CarletonURocketry/CU-in-Space-2018-Avionics-Hardware/main.brd

## EAGLE design main.brd (2018-06-05)

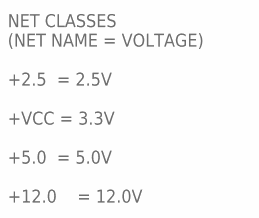
[picture p1: schematic main.sch, sheet 1]

Notes on the sheet:
NET CLASSES (NET NAME = VOLTAGE) +2.5 = 2.5V +VCC = 3.3V +5.0 = 5.0V +12.0 = 12.0V

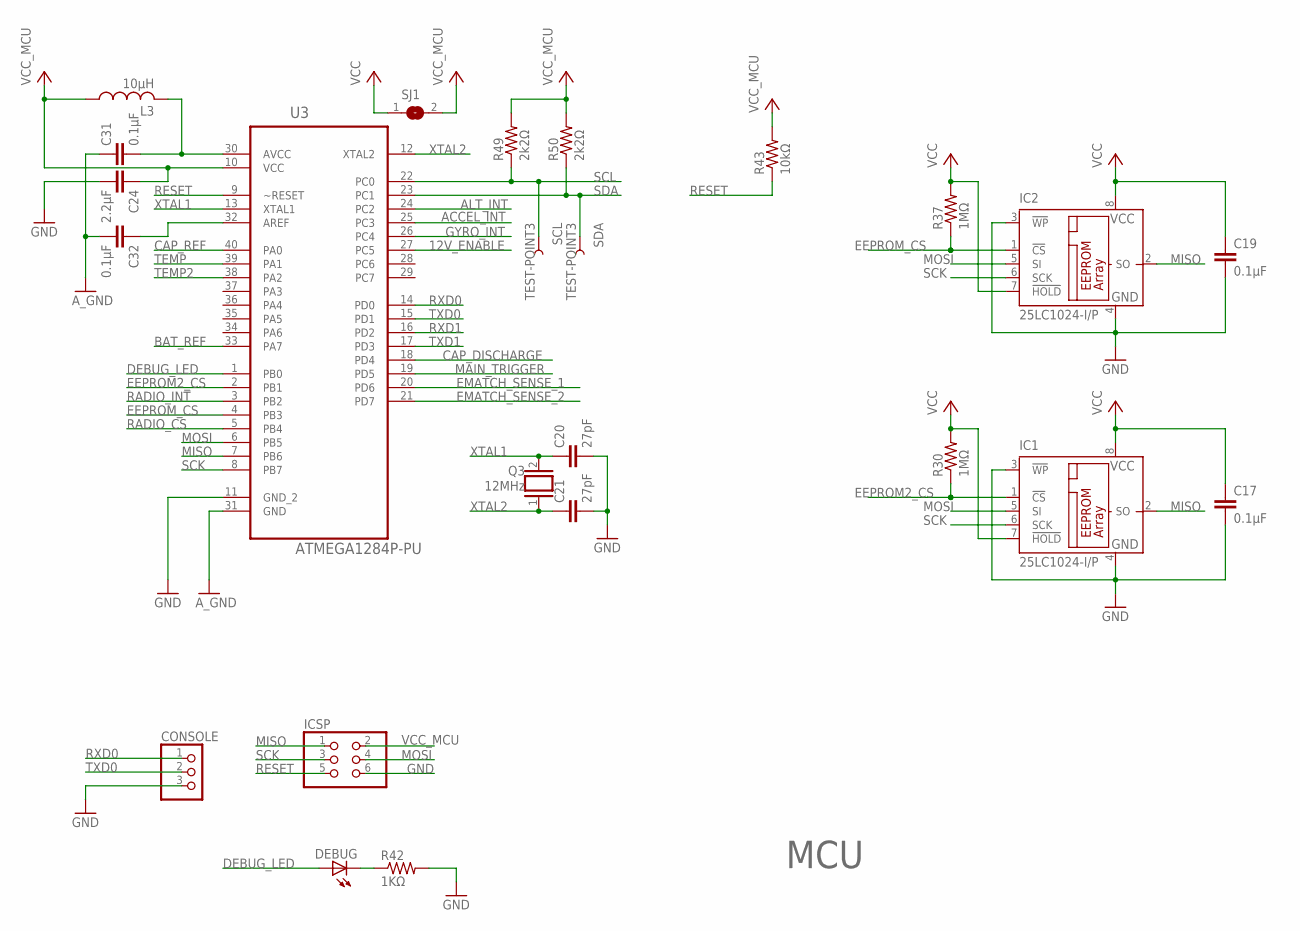
[picture p2: schematic main.sch, sheet 2, MCU]

Parts:
C17, C19, C31, C32: 0.1µF; C025-025X050
C20, C21: 27pF; C025-025X050
C24: 2.2µF; C025-025X050
CONSOLE: PINHD-1X3; 1X03
DEBUG: LED5MM
IC1, IC2: 25LC1024-I/P; DIL8
ICSP: PINHD-2X3; 2X03
L3: 10µH; 0207/5V
Q3: 12MHz; QS
R30, R37: 1MΩ; 0207/5V
R42: 1KΩ; 0207/5V
R43: 10kΩ; 0207/5V
R49, R50: 2k2Ω; 0207/5V
SCL: TEST-POINT3; PAD.03X.03
SDA: TEST-POINT3; PAD.03X.03
SJ1: SJ
U3: ATMEGA1284P-PU; DIP254P1524X483-40

Connections:
12V_ENABLE: U3.27 (PC5); also elsewhere on the board
ACCEL_INT: U3.25 (PC3); also elsewhere on the board
ALT_INT: U3.24 (PC2); also elsewhere on the board
AREF: C32.1, U3.32 (AREF)
AVCC: C31.2, L3.2, U3.30 (AVCC); also elsewhere on the board
A_GND: C31.1, C32.2, U3.31 (GND); also elsewhere on the board
BAT_REF: U3.33 (PA7); also elsewhere on the board
CAP_DISCHARGE: U3.18 (PD4); also elsewhere on the board
CAP_REF: U3.40 (PA0); also elsewhere on the board
DEBUG_LED: DEBUG.A, U3.1 (PB0)
EEPROM2_CS: IC1.1 (!CS), R30.1, U3.2 (PB1)
EEPROM_CS: IC2.1 (!CS), R37.1, U3.4 (PB3)
EMATCH_SENSE_1: U3.20 (PD6); also elsewhere on the board
EMATCH_SENSE_2: U3.21 (PD7); also elsewhere on the board
GND: C17.2, C19.2, C20.2, C21.2, C24.2, CONSOLE.3, IC1.3 (!WP), IC1.4 (GND), IC2.3 (!WP), IC2.4 (GND), ICSP.6, R42.2, U3.11 (GND_2); also elsewhere on the board
GYRO_INT: U3.26 (PC4); also elsewhere on the board
MAIN_TRIGGER: U3.19 (PD5); also elsewhere on the board
MISO: IC1.2 (SO), IC2.2 (SO), ICSP.1, U3.7 (PB6); also elsewhere on the board
MOSI: IC1.5 (SI), IC2.5 (SI), ICSP.4, U3.6 (PB5); also elsewhere on the board
unnamed: DEBUG.K (C), R42.1
RADIO_CS: U3.5 (PB4); also elsewhere on the board
RADIO_INT: U3.3 (PB2); also elsewhere on the board
RESET: ICSP.5, R43.1, U3.9 (~RESET)
RXD0: CONSOLE.1, U3.14 (PD0)
RXD1: U3.16 (PD2); also elsewhere on the board
SCK: IC1.6 (SCK), IC2.6 (SCK), ICSP.3, U3.8 (PB7); also elsewhere on the board
SCL: R49.1, SCL.P$1, U3.22 (PC0); also elsewhere on the board
SDA: R50.1, SDA.P$1, U3.23 (PC1); also elsewhere on the board
TEMP: U3.39 (PA1); also elsewhere on the board
TEMP2: U3.38 (PA2); also elsewhere on the board
TXD0: CONSOLE.2, U3.15 (PD1)
TXD1: U3.17 (PD3); also elsewhere on the board
VCC: C17.1, C19.1, IC1.7 (!HOLD), IC1.8 (VCC), IC2.7 (!HOLD), IC2.8 (VCC), R30.2, R37.2, SJ1.1; also elsewhere on the board
VCC_MCU: C24.1, ICSP.2, L3.1, R43.2, R49.2, R50.2, SJ1.2, U3.10 (VCC); also elsewhere on the board
XTAL1: C20.1, Q3.2, U3.13 (XTAL1)
XTAL2: C21.1, Q3.1, U3.12 (XTAL2)

Notes on the sheet:
MCU

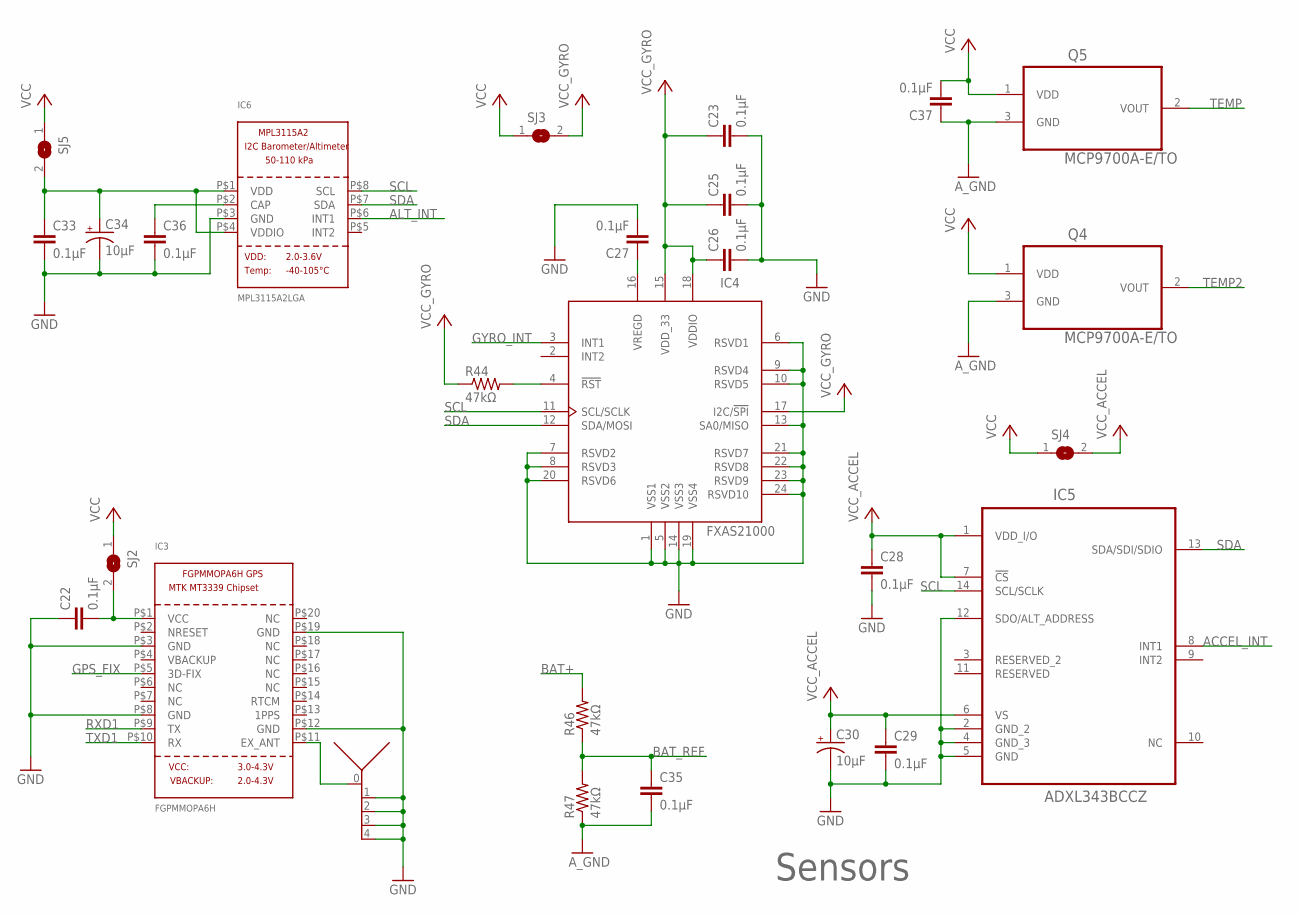
[picture p3: schematic main.sch, sheet 3, SENSORS]

Parts:
C22, C23, C25, C26, C27, C28, C29, C33, C35, C36, C37: 0.1µF; C025-025X050
C30, C34: 10µF; E2-5
IC3: FGPMMOPA6H
IC4: FXAS21000; QFN24_0P5_4X4_ASYM_EXP
IC5: ADXL343BCCZ; LGA14R80P1X6_300X500X100
IC6: MPL3115A2LGA; LGA8
Q4, Q5: MCP9700A-E/TO; TO127P254X533-3
R44, R46, R47: 47kΩ; 0207/5V
SJ2, SJ3, SJ4, SJ5: SJ
X1: 132134RP

Connections:
ACCEL_INT: IC5.8 (INT1); also elsewhere on the board
ALT_INT: IC6.P$6 (INT1); also elsewhere on the board
AVCC: C37.2, Q4.1 (VDD), Q5.1 (VDD); also elsewhere on the board
A_GND: C35.2, C37.1, Q4.3 (GND), Q5.3 (GND), R47.1; also elsewhere on the board
BAT+: R46.2; also elsewhere on the board
BAT_REF: C35.1, R46.1, R47.2; also elsewhere on the board
GND: C22.1, C23.2, C25.2, C26.2, C27.2, C28.2, C29.2, C30.-, C33.2, C34.-, C36.2, IC3.P$3 (GND), IC3.P$8 (GND), IC3.P$12 (GND), IC3.P$19 (GND), IC4.1 (VSS1), IC4.5 (VSS2), IC4.6 (RSVD1), IC4.7 (RSVD2), IC4.8 (RSVD3), IC4.9 (RSVD4), IC4.10 (RSVD5), IC4.13 (SA0/MISO), IC4.14 (VSS3), IC4.19 (VSS4), IC4.20 (RSVD6), IC4.21 (RSVD7), IC4.22 (RSVD8), IC4.23 (RSVD9), IC4.24 (RSVD10), IC5.2 (GND_2), IC5.4 (GND_3), IC5.5 (GND), IC5.12 (SDO/ALT_ADDRESS), IC6.P$3 (GND), X1.1 (GND), X1.2 (GND), X1.3 (GND), X1.4 (GND); also elsewhere on the board
GPS_FIX: IC3.P$5 (3D-FIX)
GYRO_INT: IC4.3 (INT1); also elsewhere on the board
unnamed: C27.1, IC4.16 (VREGD)
unnamed: IC4.4 (!RST), R44.2
unnamed: C36.1, IC6.P$2 (CAP)
unnamed: IC3.P$11 (EX_ANT), X1.0 (ANTENNA)
RXD1: IC3.P$9 (TX); also elsewhere on the board
SCL: IC4.11 (SCL/SCLK), IC5.14 (SCL/SCLK), IC6.P$8 (SCL); also elsewhere on the board
SDA: IC4.12 (SDA/MOSI), IC5.13 (SDA/SDI/SDIO), IC6.P$7 (SDA); also elsewhere on the board
TEMP: Q5.2 (VOUT); also elsewhere on the board
TEMP2: Q4.2 (VOUT); also elsewhere on the board
TXD1: IC3.P$10 (RX); also elsewhere on the board
VCC: SJ2.1, SJ3.1, SJ4.1, SJ5.1; also elsewhere on the board
VCC_ACCEL: C28.1, C29.1, C30.+, IC5.1 (VDD_I/O), IC5.6 (VS), IC5.7 (!CS), SJ4.2
VCC_ALT: C33.1, C34.+, IC6.P$1 (VDD), IC6.P$4 (VDDIO), SJ5.2
VCC_GPS: C22.2, IC3.P$1 (VCC), SJ2.2
VCC_GYRO: C23.1, C25.1, C26.1, IC4.15 (VDD_33), IC4.17 (I2C/!SPI), IC4.18 (VDDIO), R44.1, SJ3.2

Notes on the sheet:
Sensors

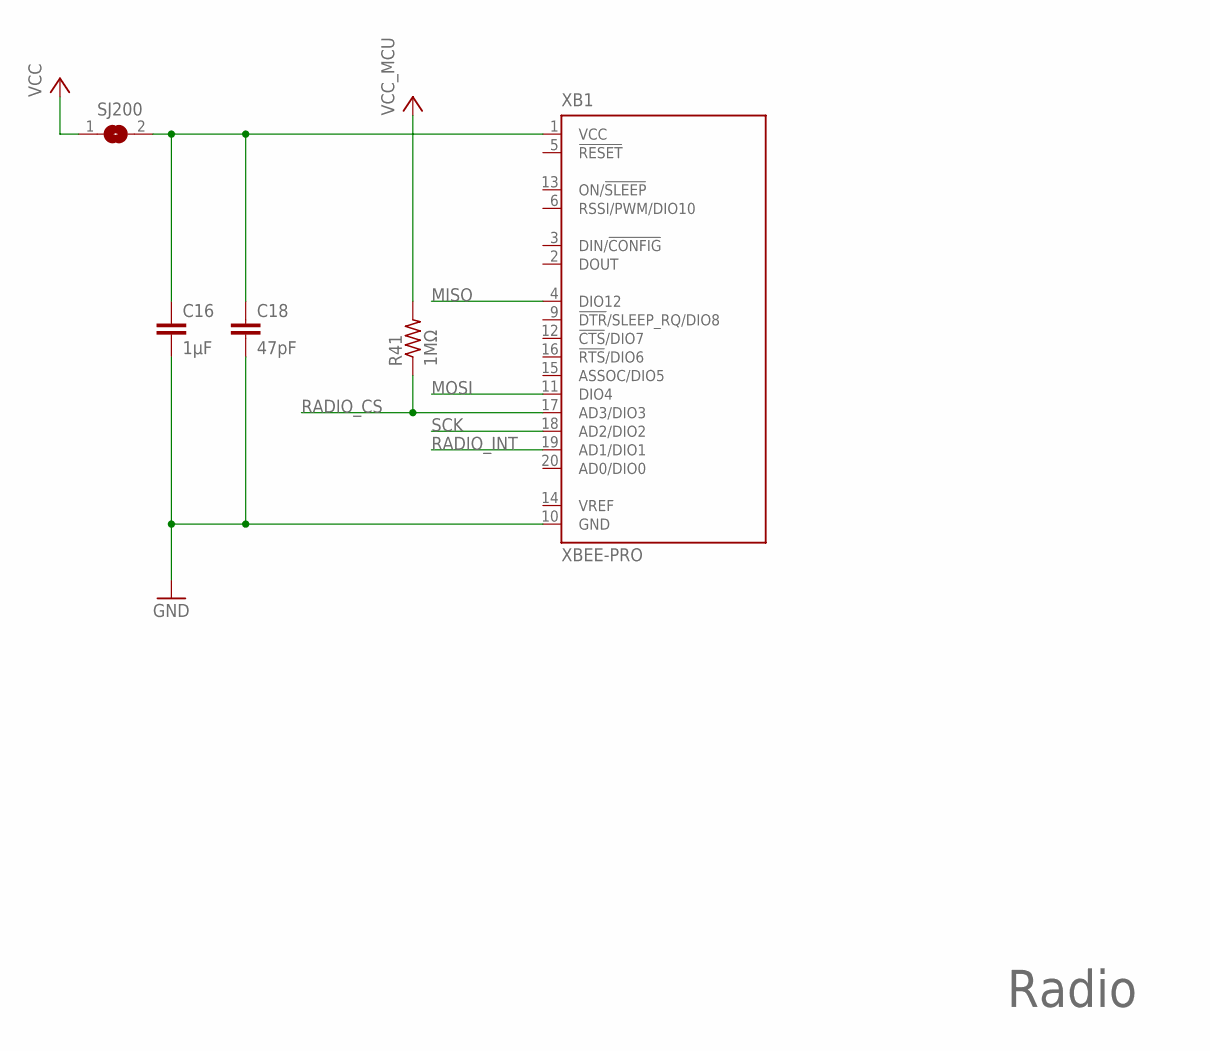
[picture p4: schematic main.sch, sheet 4, RADIO]

Parts:
C16: 1µF; C025-025X050
C18: 47pF; C025-025X050
R41: 1MΩ; 0207/5V
SJ200: SJ
XB1: XBEE-PRO

Connections:
GND: C16.2, C18.2, XB1.10 (GND); also elsewhere on the board
MISO: XB1.4 (DIO12); also elsewhere on the board
MOSI: XB1.11 (DIO4); also elsewhere on the board
RADIO_CS: R41.1, XB1.17 (AD3/DIO3); also elsewhere on the board
RADIO_INT: XB1.19 (AD1/DIO1); also elsewhere on the board
SCK: XB1.18 (AD2/DIO2); also elsewhere on the board
VCC: SJ200.1; also elsewhere on the board
VCC_MCU: R41.2; also elsewhere on the board
VCC_XB: C16.1, C18.1, SJ200.2, XB1.1 (VCC)

Notes on the sheet:
Radio

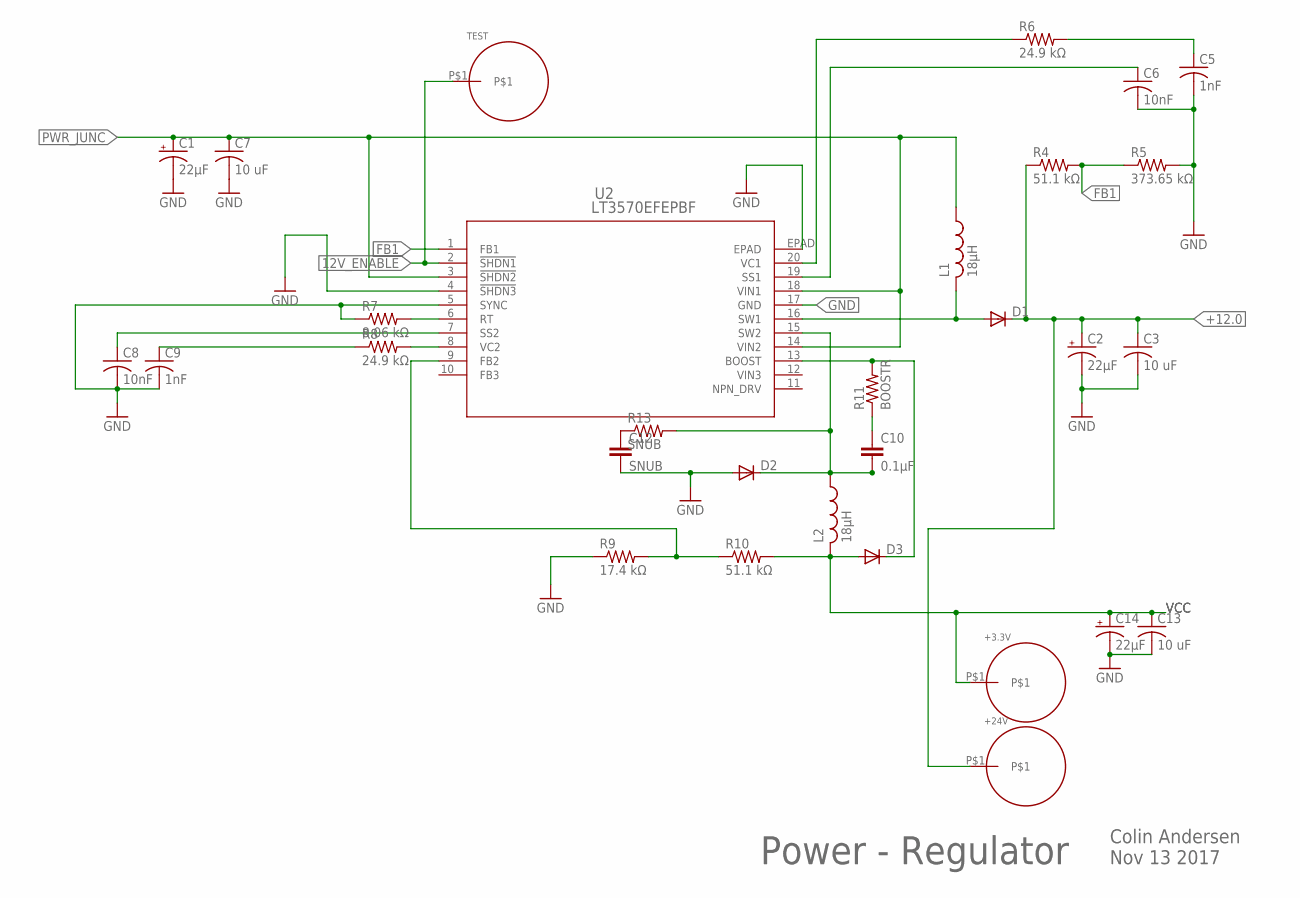
[picture p5: schematic main.sch, sheet 5, Power Regulatror]

Parts:
C1, C2, C14: 22µF; 2.5MM_AL_CAP
C3, C7, C13: 10 uF; 2.5MM_CAP
C5, C9: 1nF; 2.5MM_CAP
C6, C8: 10nF; 2.5MM_CAP
C10: 0.1µF; C025-025X050
C12: SNUB; C025-025X050
D1, D2, D3: SB230TA; 11.6MM_D
L1, L2: 18µH; 5.4MM_L
R4, R10: 51.1 kΩ; 0207/5V
R5: 373.65 kΩ; 0207/5V
R6, R8: 24.9 kΩ; 0207/5V
R7: 8.06 kΩ; 0207/5V
R9: 17.4 kΩ; 0207/5V
R11: BOOSTR; 0207/5V
R13: SNUB; 0207/5V
U2: LT3570EFEPBF; TSSOP-20_FE/CB
U$2: +24V; TEST
U$3: +3.3V; TEST
U$5: TEST

Connections:
12V_ENABLE: U2.2 (!SHDN1), U$5.P$1; also elsewhere on the board
+12.0: C2.1 (+), C3.1, D1.1 (C), R4.1, U$2.P$1; also elsewhere on the board
FB1: R4.2, R5.1, U2.1 (FB1)
GND: C1.2 (-), C2.2 (-), C3.2, C5.2, C6.2, C7.2, C8.2, C9.2, C12.2, C13.2, C14.2 (-), D2.2 (A), R5.2, R7.1, R9.1, U2.4 (!SHDN3), U2.5 (SYNC), U2.17 (GND), U2.EPAD; also elsewhere on the board
unnamed: C8.1, U2.7 (SS2)
unnamed: R7.2, U2.6 (RT)
unnamed: R8.2, U2.8 (VC2)
unnamed: D1.2 (A), L1.2, U2.16 (SW1)
unnamed: C5.1, R6.2
unnamed: C9.1, R8.1
unnamed: R6.1, U2.20 (VC1)
unnamed: C6.1, U2.19 (SS1)
unnamed: C10.2, D2.1 (C), L2.1, R13.2, U2.15 (SW2)
unnamed: R9.2, R10.1, U2.9 (FB2)
unnamed: D3.1 (C), R11.2, U2.13 (BOOST)
unnamed: C12.1, R13.1
unnamed: C10.1, R11.1
PWR_JUNC: C1.1 (+), C7.1, L1.1, U2.3 (!SHDN2), U2.14 (VIN2), U2.18 (VIN1); also elsewhere on the board
VCC: C13.1, C14.1 (+), D3.2 (A), L2.2, R10.2, U$3.P$1; also elsewhere on the board

Notes on the sheet:
Power - Regulator
Colin Andersen Nov 13 2017

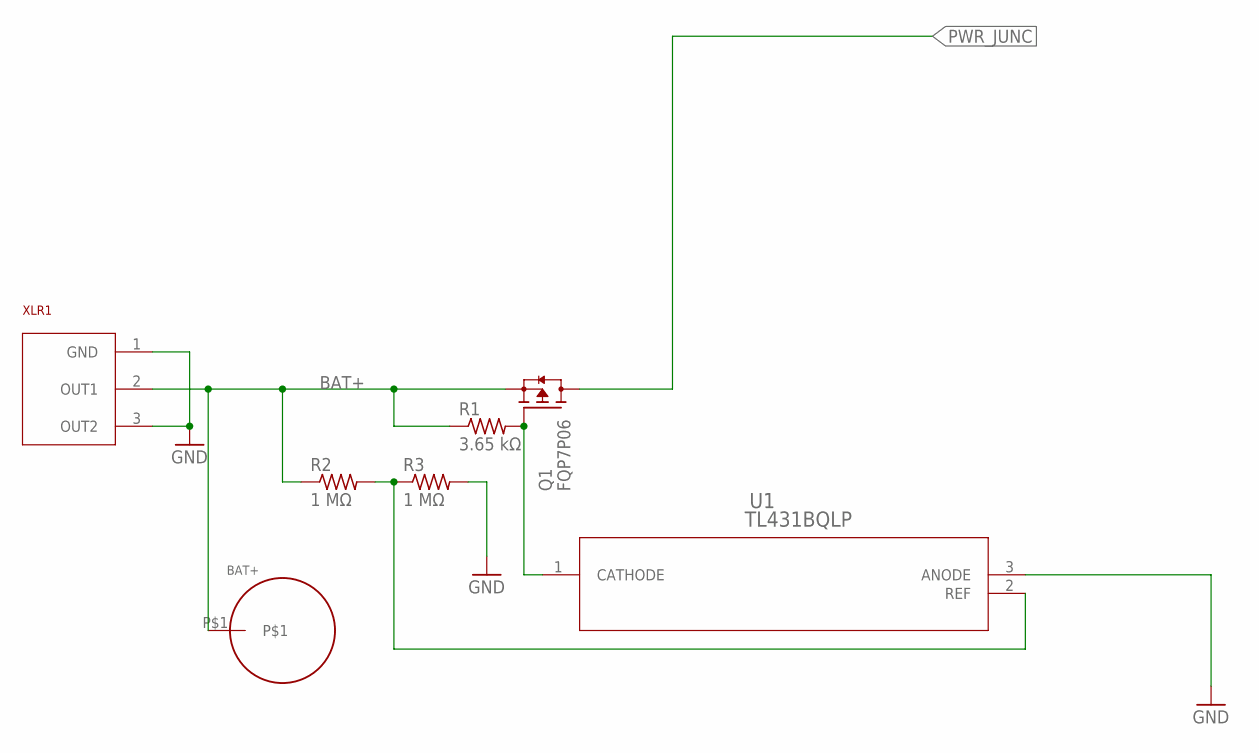
[picture p6: schematic main.sch, sheet 6, Battery Voltage cutoff circuit]

Parts:
Q1: FQP7P06; PMOS
R1: 3.65 kΩ; 0207/5V
R2, R3: 1 MΩ; 0207/5V
U1: TL431BQLP; LP3
U$1: BAT+; TEST
XLR1: NC3FAH1

Connections:
BAT+: Q1.3 (S), R1.1, R2.1, U$1.P$1, XLR1.2 (OUT1); also elsewhere on the board
GND: R3.2, U1.3 (ANODE), XLR1.1 (GND), XLR1.3 (OUT2); also elsewhere on the board
unnamed: Q1.1 (G), R1.2, U1.1 (CATHODE)
unnamed: R2.2, R3.1, U1.2 (REF)
PWR_JUNC: Q1.2 (D); also elsewhere on the board

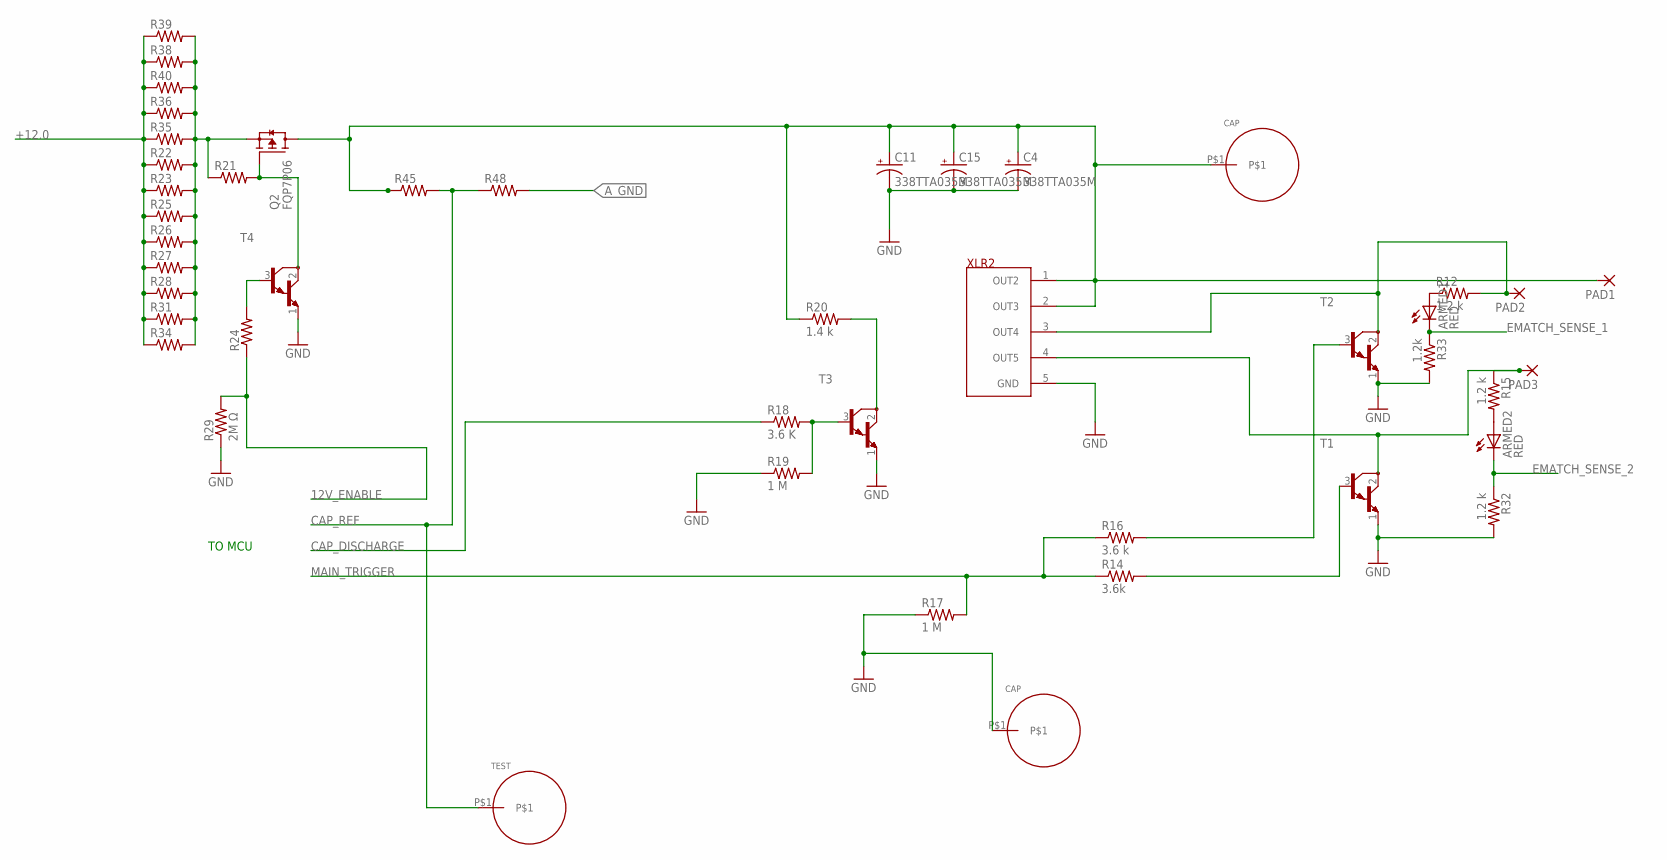
[picture p7: schematic main.sch, sheet 7, Capictor bank and key switch]

Parts:
ARMED1, ARMED2: RED; LED5MM
C4, C11, C15: 338TTA035M
PAD1, PAD2, PAD3: CRIMP; 3,81/1,4
Q2: FQP7P06; PMOS
R12, R15, R32: 1.2 k; 0207/5V
R14: 3.6k; 0207/5V
R16: 3.6 k; 0207/5V
R17, R19: 1 M; 0207/5V
R18: 3.6 K; 0207/5V
R20: 1.4 k; 0207/5V
R21, R22, R23, R24, R25, R26, R27, R28, R31, R34, R35, R36, R38, R39, R40, R45, R48: R-US_0207/5V; 0207/5V
R29: 2M Ω; 0207/5V
R33: 1.2k; 0207/5V
T1, T2, T3, T4: -NPN_DARL-; NPNDARL
U$4, U$6: CAP; TEST
U$7: TEST
XLR2: NC5FAH

Connections:
12V_ENABLE: R24.1, R29.2; also elsewhere on the board
+12.0: R22.1, R23.1, R25.1, R26.1, R27.1, R28.1, R31.1, R34.1, R35.1, R36.1, R38.1, R39.1, R40.1; also elsewhere on the board
A_GND: R48.2; also elsewhere on the board
CAP_DISCHARGE: R18.1; also elsewhere on the board
CAP_REF: R45.2, R48.1, U$7.P$1; also elsewhere on the board
EMATCH_SENSE_1: ARMED1.K (C), R33.1; also elsewhere on the board
EMATCH_SENSE_2: ARMED2.K (C), R32.1; also elsewhere on the board
GND: C4.-, C11.-, C15.-, R17.1, R19.1, R29.1, R32.2, R33.2, T1.1 (E), T2.1 (E), T3.1 (E), T4.1 (E), U$4.P$1, XLR2.5 (GND); also elsewhere on the board
MAIN_TRIGGER: R14.1, R16.1, R17.2; also elsewhere on the board
unnamed: Q2.3 (S), R21.1, R22.2, R23.2, R25.2, R26.2, R27.2, R28.2, R31.2, R34.2, R35.2, R36.2, R38.2, R39.2, R40.2
unnamed: Q2.1 (G), R21.2, T4.2 (C)
unnamed: R20.2, T3.2 (C)
unnamed: R24.2, T4.3 (B)
unnamed: PAD3.1, R15.1, T1.2 (C), XLR2.4 (OUT5)
unnamed: PAD2.1, R12.2, T2.2 (C), XLR2.3 (OUT4)
unnamed: R16.2, T2.3 (B)
unnamed: R14.2, T1.3 (B)
unnamed: C4.+, C11.+, C15.+, PAD1.1, Q2.2 (D), R20.1, R45.1, U$6.P$1, XLR2.1 (OUT2), XLR2.2 (OUT3)
unnamed: R18.2, R19.2, T3.3 (B)
unnamed: ARMED2.A, R15.2
unnamed: ARMED1.A, R12.1

Notes on the sheet:
TO MCU

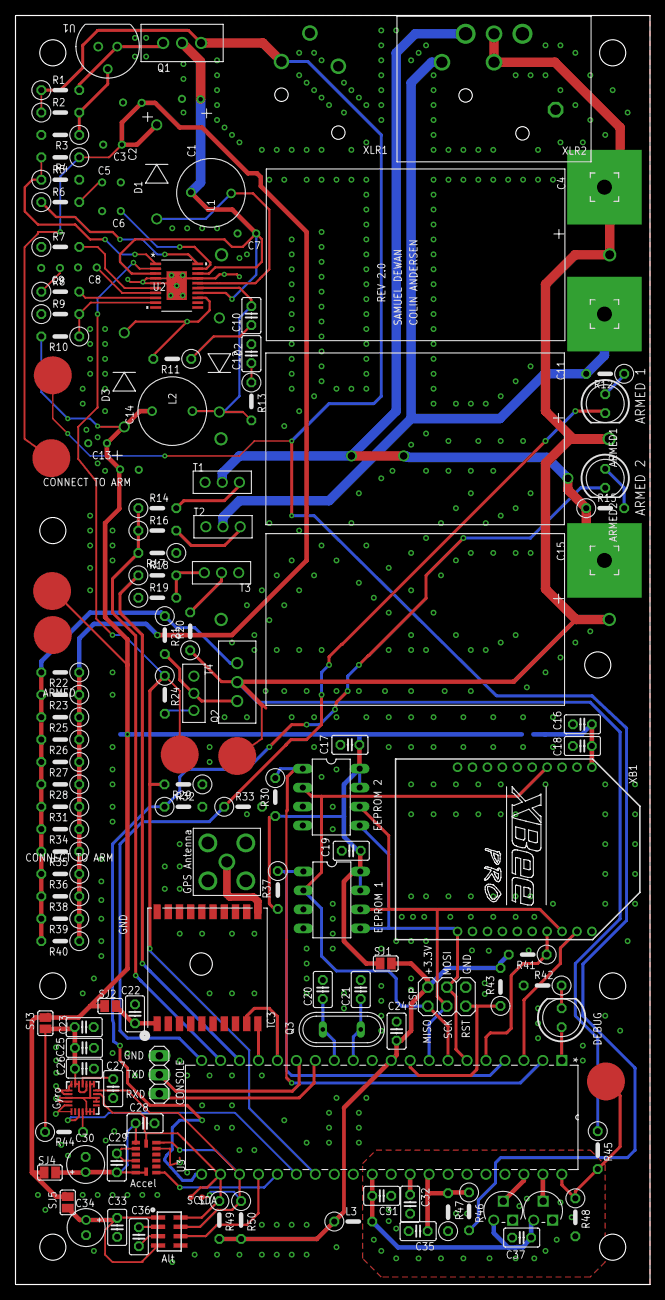
[picture p8: board main.brd from above]

Board: 2 copper layers, 85.0 x 170.0 mm, 138 parts (1 on the bottom side), 76 nets.
