CarletonURocketry/CU-in-Space-2018-Avionics-Hardware/(commit log)

2017-10-28 Added rough schematic, board and libraries.
    [main.brd, main.sch]
2017-11-02 Added datasheet for MCP9700A temperature sensor and added ambient temperature sensor to schematic.
    [main.brd, main.sch]
2017-11-02 Added high value pullups to SPI CS pins to avoid problems during programming
    [main.brd, main.sch]
2017-11-13 Voltage Regulator added
    [main.brd, main.sch]
2017-11-21 Mostly routed
    [main.sch]
2017-11-23 Updated Datasheets
    [main.brd, main.sch]
2018-01-20 Added MCU, Sensors and Radios
    [main.brd, main.sch]
2018-02-01 Finished Power bank
    Finished Power bank.
    To do:
    Key switch
    Short circuit protection (PTCs)
    [main.brd, main.sch]
2018-02-01 Added more
    [main.brd]
2018-02-01 Added terminal pads
    [main.brd, main.sch]
2018-02-01 Added Pads
    [main.brd, main.sch]
2018-02-03 Changed armed sense so that the pin is pulled low when armed and added resistor for armed LED.
    [main.brd, main.sch]
2018-02-03 Fixed ERC errors and renumbered all components.
    [main.brd, main.sch]
2018-03-30 Relayed-out digital section.
    [main.brd, main.sch]
2018-04-02 panannnananael
    pannel
    [PANNEL_Final.brd]
2018-04-02 Isolation slots
    [PANNEL_Final.brd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]
